pakutoma/gba-dumper-rp2040/board/gba-dumper.kicad_sch

## KiCad design board/gba-dumper.kicad_sch (2025-02-21)

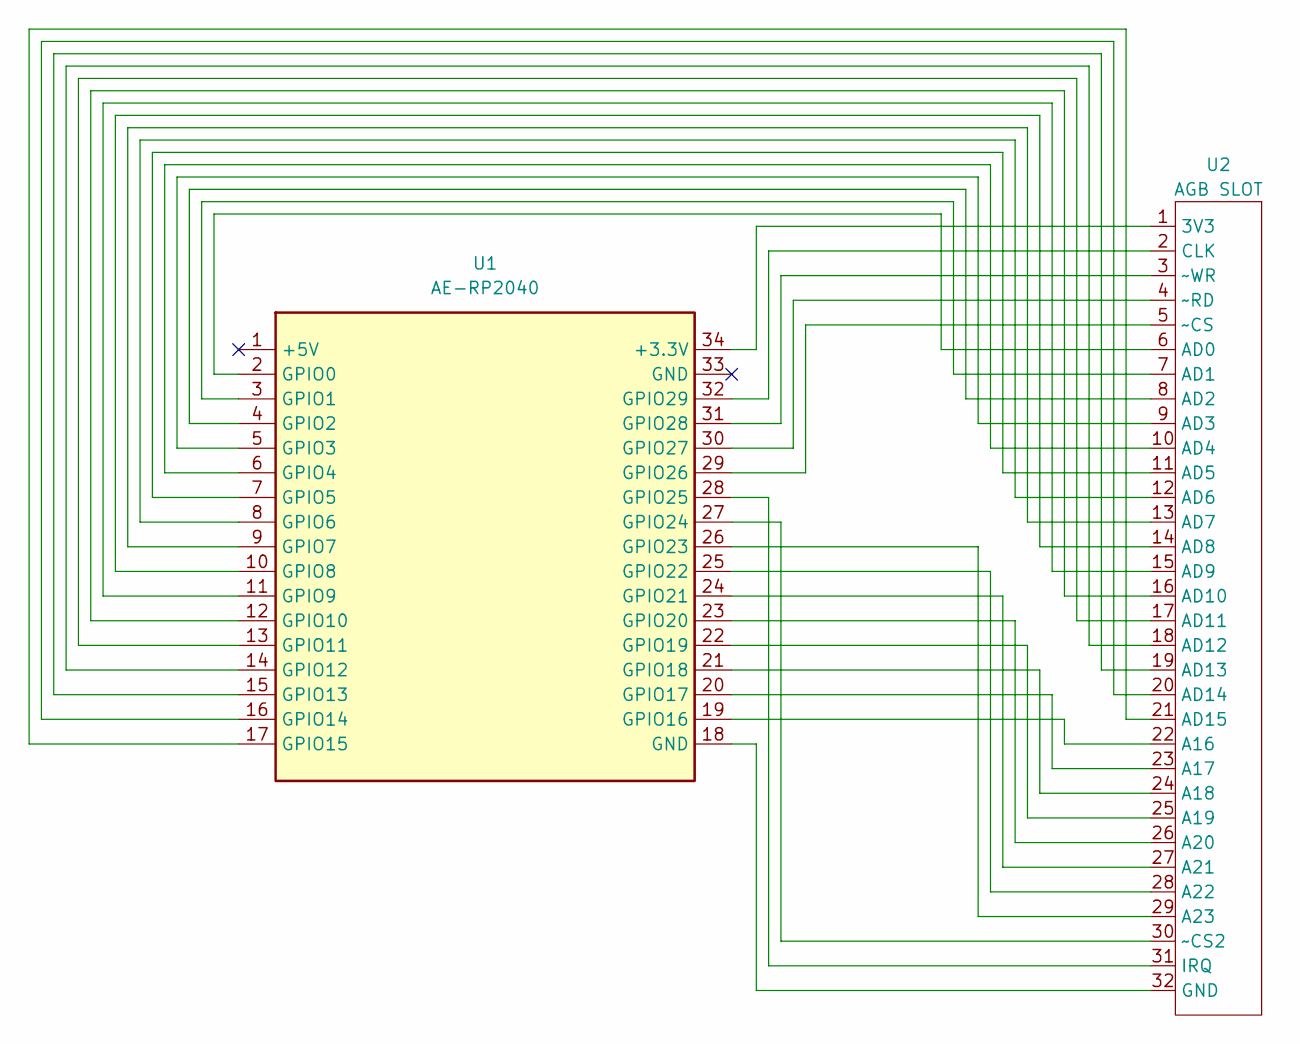
[picture p1: schematic gba-dumper.kicad_sch]

Parts:
U1: AE-RP2040
U2: AGB SLOT; GBA_cartridge

Connections:
unnamed: U1.2 (GPIO0), U2.6 (AD0)
unnamed: U1.3 (GPIO1), U2.7 (AD1)
unnamed: U1.4 (GPIO2), U2.8 (AD2)
unnamed: U1.5 (GPIO3), U2.9 (AD3)
unnamed: U1.6 (GPIO4), U2.10 (AD4)
unnamed: U1.7 (GPIO5), U2.11 (AD5)
unnamed: U1.8 (GPIO6), U2.12 (AD6)
unnamed: U1.9 (GPIO7), U2.13 (AD7)
unnamed: U1.10 (GPIO8), U2.14 (AD8)
unnamed: U1.11 (GPIO9), U2.15 (AD9)
unnamed: U1.12 (GPIO10), U2.16 (AD10)
unnamed: U1.13 (GPIO11), U2.17 (AD11)
unnamed: U1.14 (GPIO12), U2.18 (AD12)
unnamed: U1.15 (GPIO13), U2.19 (AD13)
unnamed: U1.16 (GPIO14), U2.20 (AD14)
unnamed: U1.17 (GPIO15), U2.21 (AD15)
unnamed: U1.18 (GND), U2.32 (GND)
unnamed: U1.19 (GPIO16), U2.22 (A16)
unnamed: U1.20 (GPIO17), U2.23 (A17)
unnamed: U1.21 (GPIO18), U2.24 (A18)
unnamed: U1.22 (GPIO19), U2.25 (A19)
unnamed: U1.23 (GPIO20), U2.26 (A20)
unnamed: U1.24 (GPIO21), U2.27 (A21)
unnamed: U1.25 (GPIO22), U2.28 (A22)
unnamed: U1.26 (GPIO23), U2.29 (A23)
unnamed: U1.27 (GPIO24), U2.30 (~CS2)
unnamed: U1.28 (GPIO25), U2.31 (IRQ)
unnamed: U1.29 (GPIO26), U2.5 (~CS)
unnamed: U1.30 (GPIO27), U2.4 (~RD)
unnamed: U1.31 (GPIO28), U2.3 (~WR)
unnamed: U1.32 (GPIO29), U2.2 (CLK)
unnamed: U1.34 (+3.3V), U2.1 (3V3)
